peakprojections/peak-control-hat/README.md

# peak-control-hat
KiCad schematic and build files for the Peak Control Hat used with the Peak Controller Raspberry Pi
