peakprojections/peak-control-hat/Peak_Control_2CH_SSR_Interface_RevA/Peak_Control_2CH_SSR_Interface_RevA.kicad_pcb

## KiCad design Peak_Control_2CH_SSR_Interface_RevA/Peak_Control_2CH_SSR_Interface_RevA.kicad_pcb (2026-09-03)

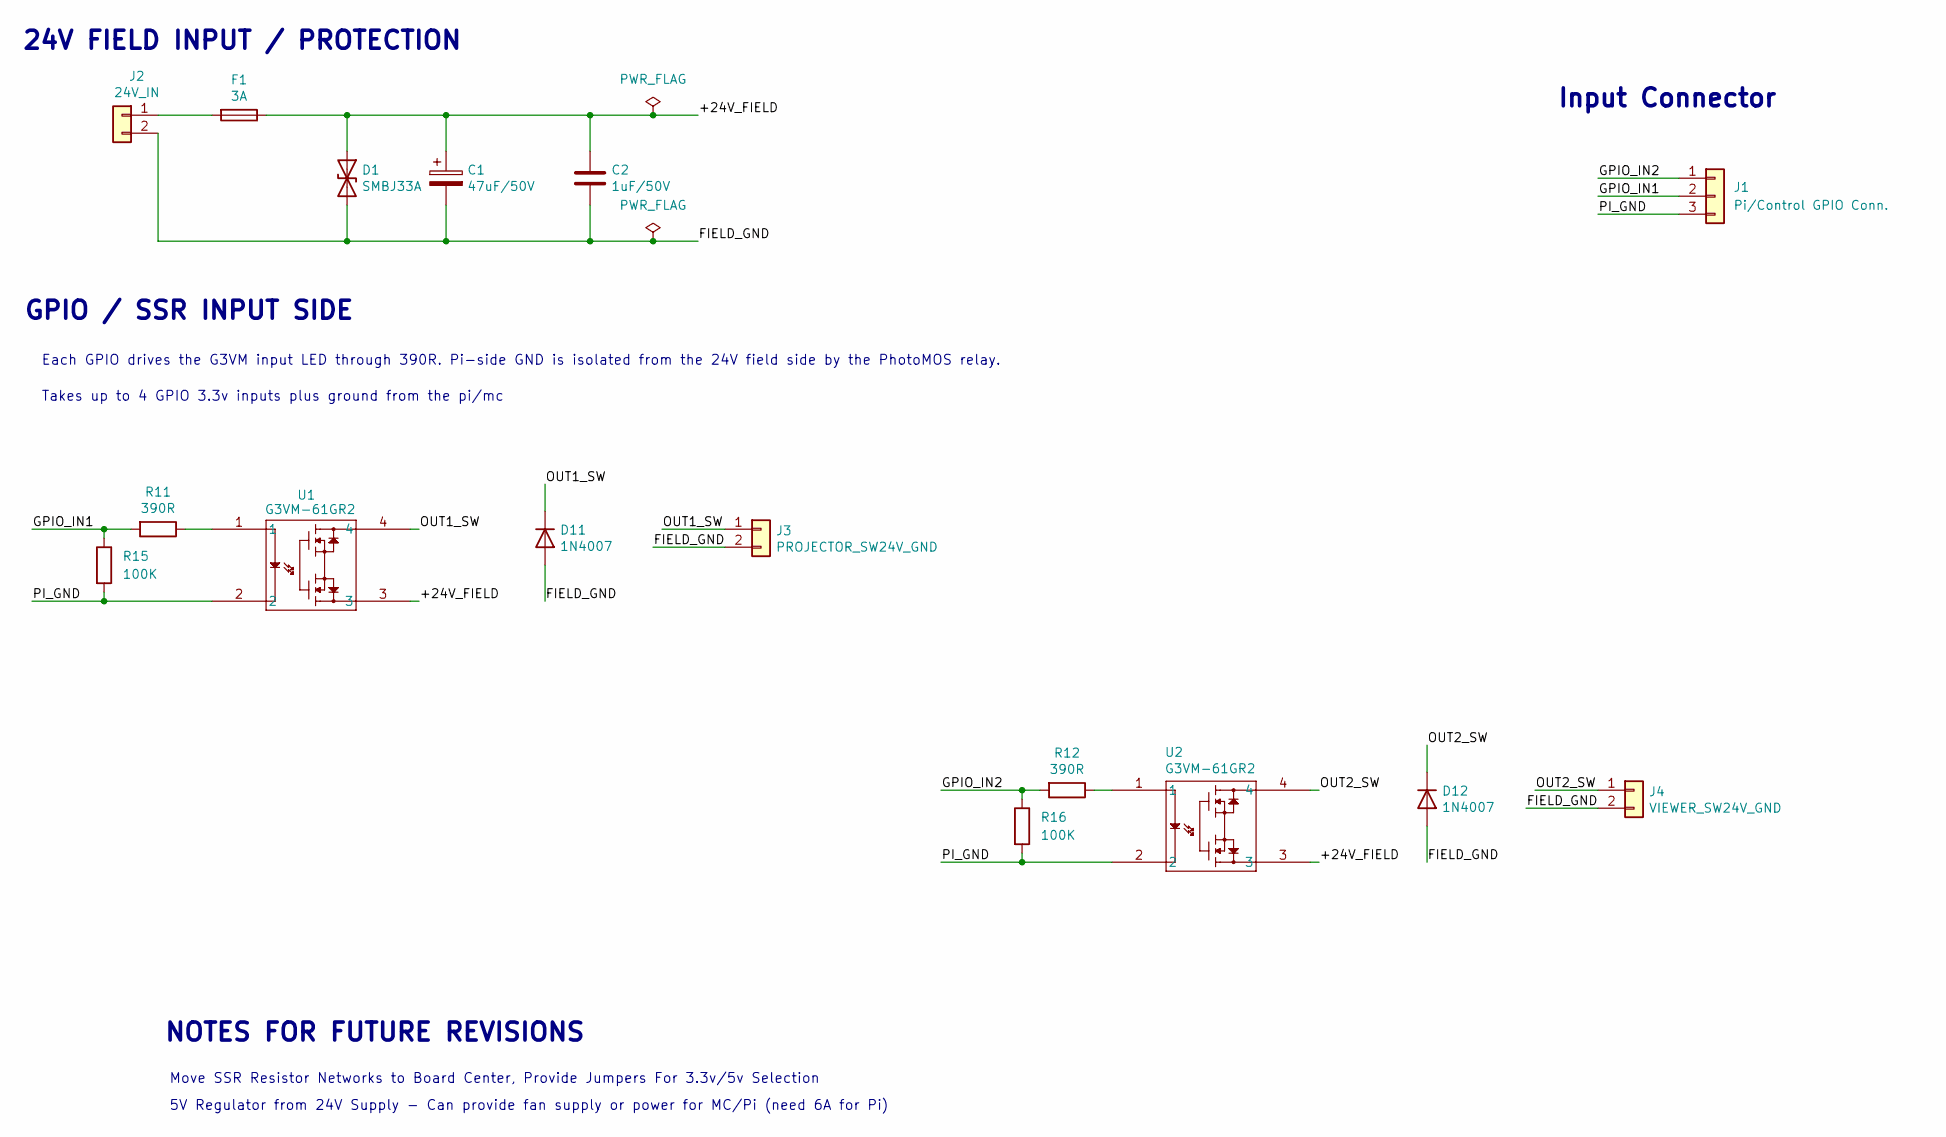
[picture p1: schematic Peak_Control_2CH_SSR_Interface_RevA.kicad_sch, Peak Control 2CH SSR Interface Rev A1.1]

Parts:
C1: 47uF/50V; CP_Radial_D8.0mm_P3.50mm; MPN 50RX3047MT78X11.5
C2: 1uF/50V; C_0805_2012Metric_Pad1.18x1.45mm_HandSolder; MPN 08055C105K4T2A
D1: SMBJ33A; D_SMB_Handsoldering; MPN SMBJ33A
D11, D12: 1N4007; D_DO-41_SOD81_P10.16mm_Horizontal; MPN 1N4007
F1: 3A; FUSE-TH_L22.6-W9.0; MPN 5x20 BLX-A XC-7
J1: Pi/Control GPIO Conn.; CONN-TH_3P-P5.08_DIBO_DB128V-5.08-3P-X; MPN DB128V-5.08-3P-GN-S
J2: 24V_IN; CONN-TH_YC0220500000G; MPN YC0220500000G
J3: PROJECTOR_SW24V_GND; CONN-TH_YC0220500000G; MPN YC0220500000G
J4: VIEWER_SW24V_GND; CONN-TH_YC0220500000G; MPN YC0220500000G
R11, R12: 390R; R_0805_2012Metric_Pad1.20x1.40mm_HandSolder; MPN RC0805FR-07390RL
R15, R16: 100K; R_0805_2012Metric_Pad1.20x1.40mm_HandSolder; MPN RC0805FR-07100KL
U1, U2: G3VM-61GR2; G-SOP4_OMR; MPN G3VM-61GR2(TR05)

Connections:
/+24V_FIELD: C1.1, C2.1, D1.1 (A1), F1.1, U1.3, U2.3
/FIELD_GND: C1.2, C2.2, D1.2 (A2), D11.2 (A), D12.2 (A), J2.2, J3.2, J4.2
/GPIO_IN1: J1.2, R11.2, R15.1
/GPIO_IN2: J1.1, R12.2, R16.1
/OUT1_SW: D11.1 (K), J3.1, U1.4
/OUT2_SW: D12.1 (K), J4.1, U2.4
/PI_GND: J1.3, R15.2, R16.2, U1.2, U2.2
unnamed: F1.2, J2.1
unnamed: R11.1, U1.1
unnamed: R12.1, U2.1

Notes on the sheet:
NOTES FOR FUTURE REVISIONS
Each GPIO drives the G3VM input LED through 390R. Pi-side GND is isolated from the 24V field side by the PhotoMOS relay.
5V Regulator from 24V Supply - Can provide fan supply or power for MC/Pi (need 6A for Pi)
Input Connector
24V FIELD INPUT / PROTECTION
GPIO / SSR INPUT SIDE
Move SSR Resistor Networks to Board Center, Provide Jumpers For 3.3v/5v Selection
Takes up to 4 GPIO 3.3v inputs plus ground from the pi/mc

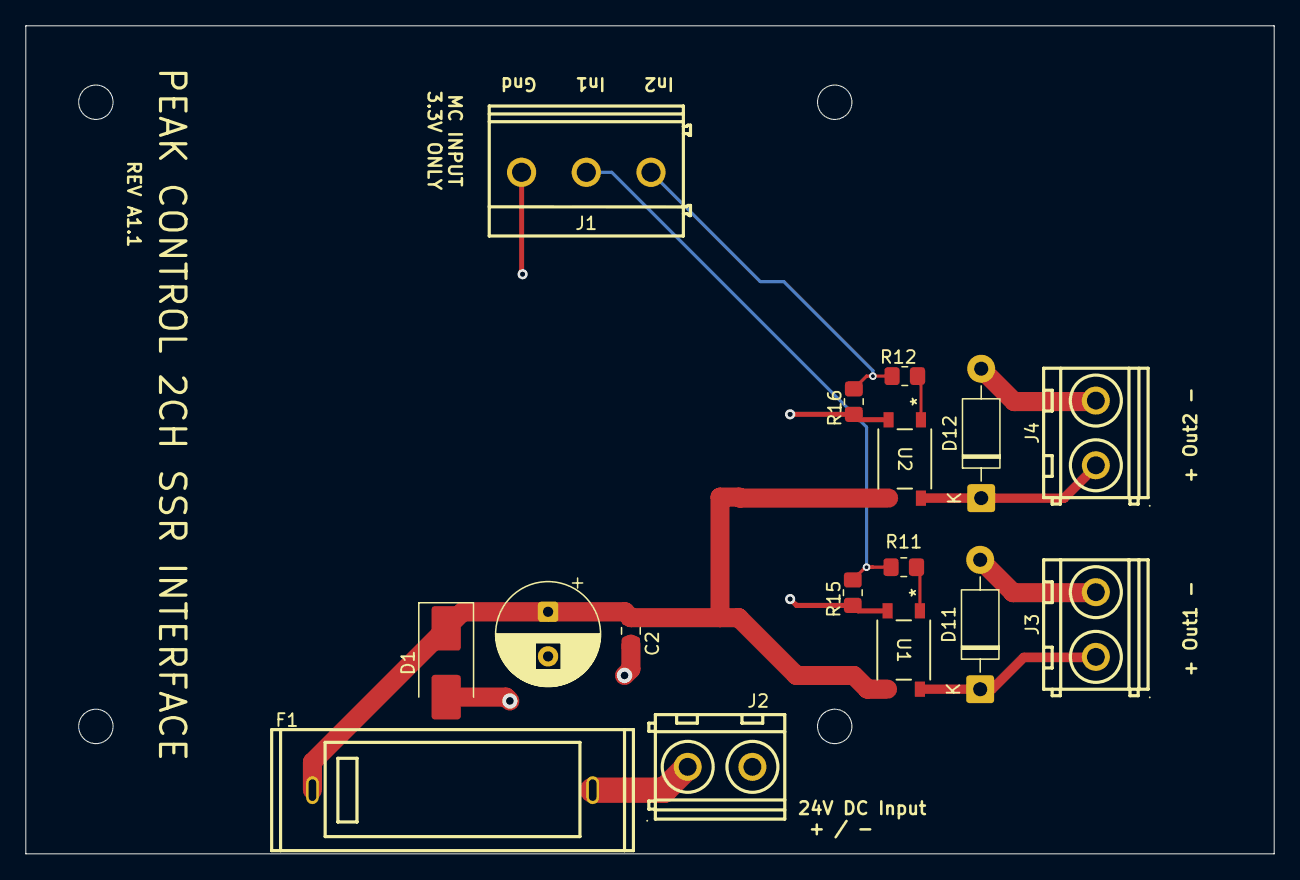
[picture p2: board Peak_Control_2CH_SSR_Interface_RevA.kicad_pcb from above]

Board: 4 copper layers, 98.0 x 65.0 mm, 16 parts (0 on the bottom side), 10 nets.
