peakprojections/peak-control-hat/Peak_Control_HAT_SSR_RevA/Peak_Control_HAT_SSR_RevA.kicad_pcb

## KiCad design Peak_Control_HAT_SSR_RevA/Peak_Control_HAT_SSR_RevA.kicad_pcb (2026-09-01)

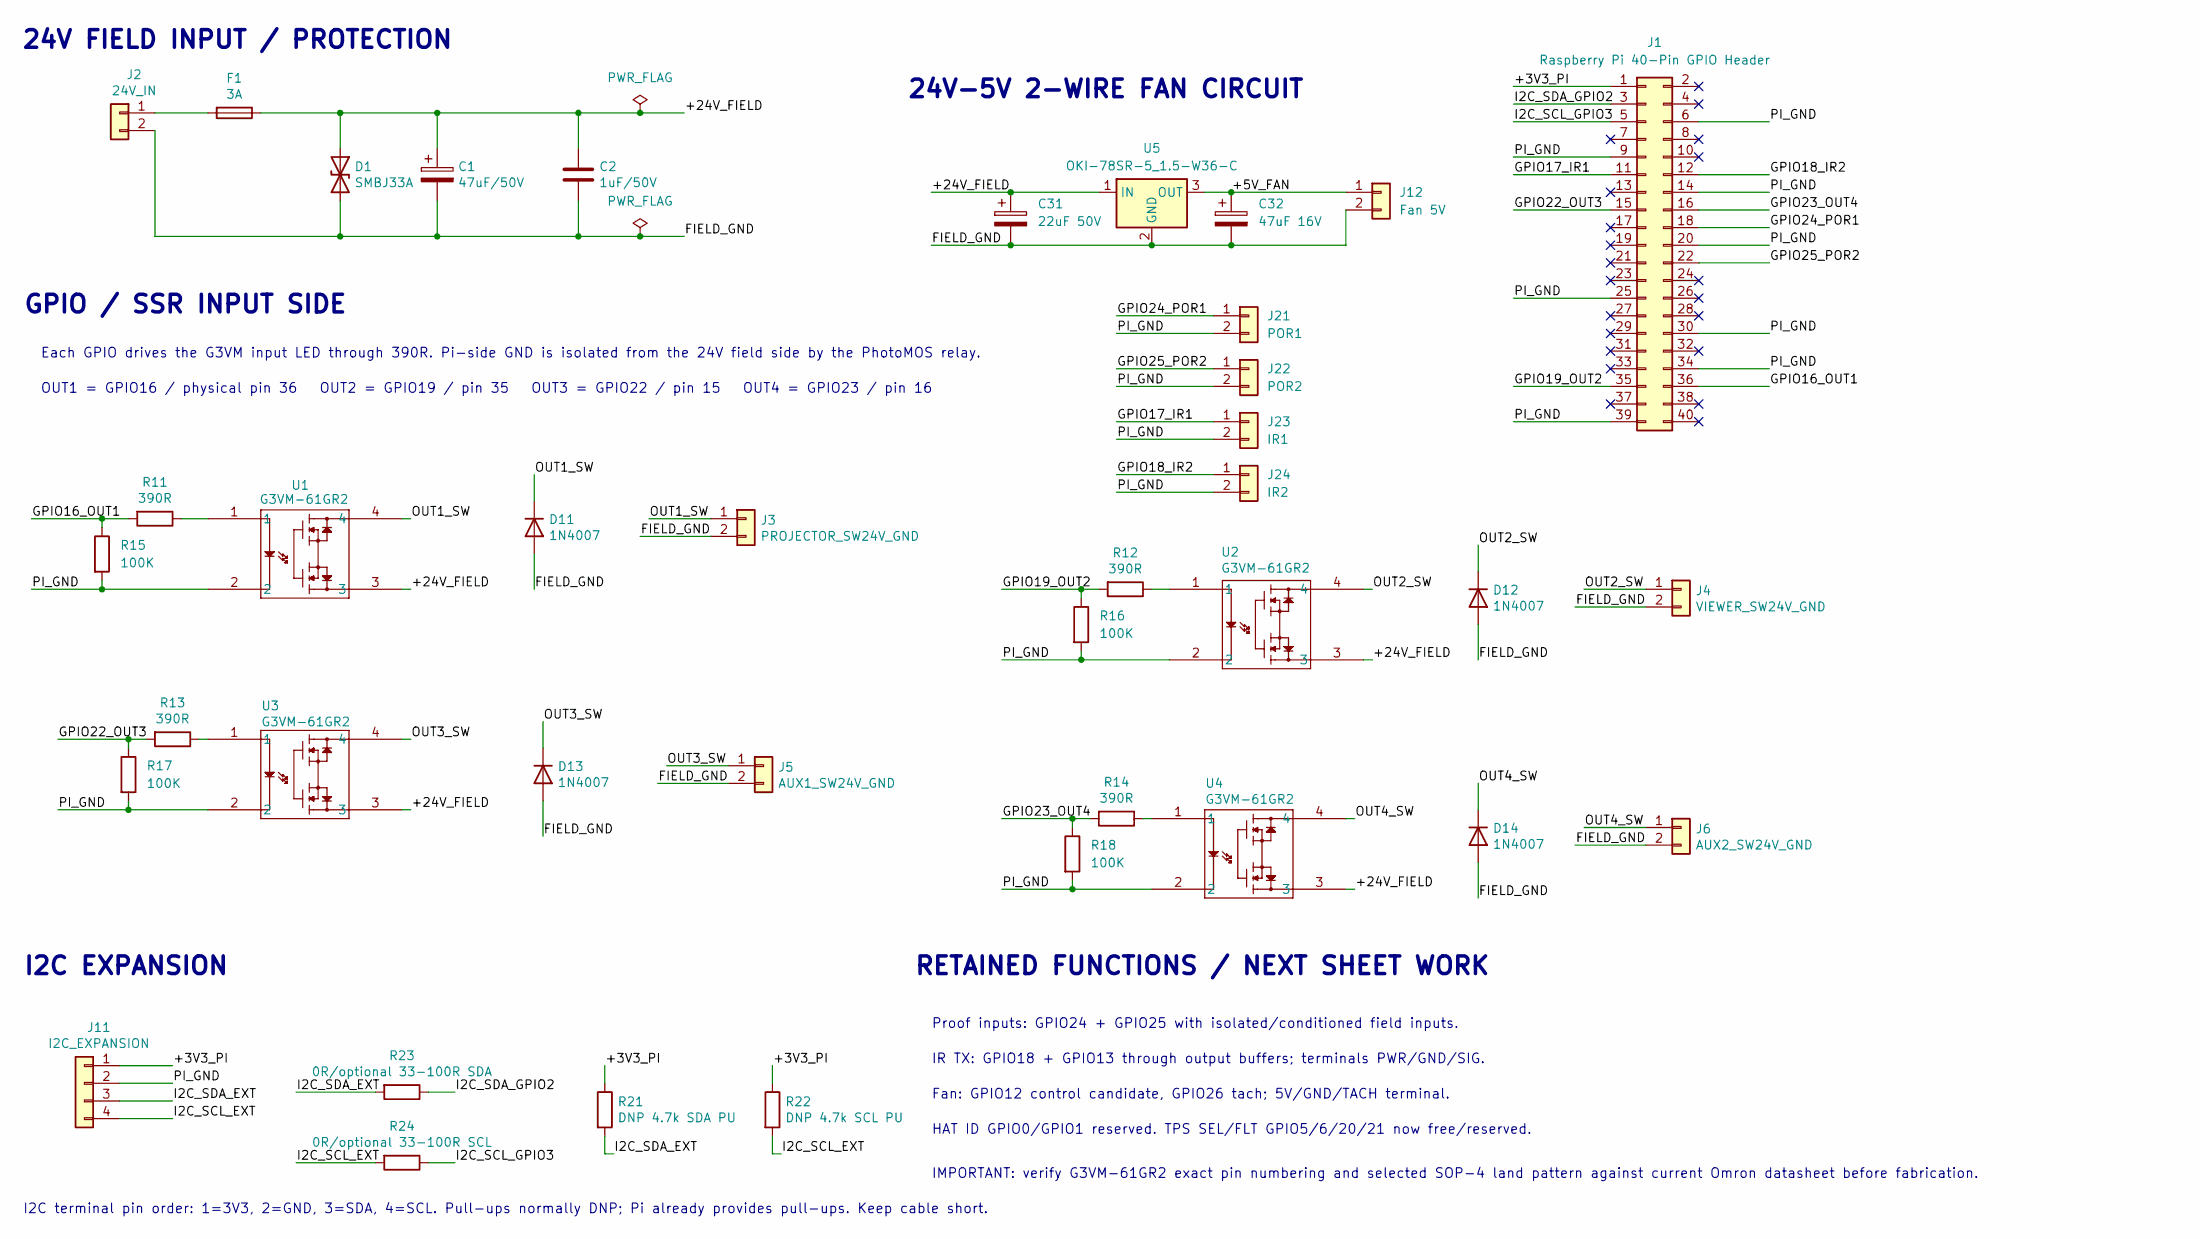
[picture p3: schematic Peak_Control_HAT_SSR_RevA.kicad_sch, Peak Control HAT SSR Rev A - Power Output Core]

Parts:
C1: 47uF/50V; CP_Radial_D8.0mm_P3.50mm
C2: 1uF/50V; C_0805_2012Metric_Pad1.18x1.45mm_HandSolder
C31: 22uF 50V; CP_Radial_D5.0mm_P2.00mm
C32: 47uF 16V; CP_Radial_D5.0mm_P2.00mm
D1: SMBJ33A; D_SMB_Handsoldering
D11, D12, D13, D14: 1N4007; D_DO-41_SOD81_P10.16mm_Horizontal
F1: 3A; Fuseholder_Clip-5x20mm_Bel_FC-203-22_Lateral_P17.80x5.00mm_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
J1: Raspberry Pi 40-Pin GPIO Header; PinSocket_2x20_P2.54mm_Vertical
J2: 24V_IN; TerminalBlock_Phoenix_MKDS-1,5-2-5.08_1x02_P5.08mm_Horizont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
J3: PROJECTOR_SW24V_GND; TerminalBlock_Phoenix_MKDS-1,5-2-5.08_1x02_P5.08mm_Horizont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
J4: VIEWER_SW24V_GND; TerminalBlock_Phoenix_MKDS-1,5-2-5.08_1x02_P5.08mm_Horizont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
J5: AUX1_SW24V_GND; TerminalBlock_Phoenix_MKDS-1,5-2-5.08_1x02_P5.08mm_Horizont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
J6: AUX2_SW24V_GND; TerminalBlock_Phoenix_MKDS-1,5-2-5.08_1x02_P5.08mm_Horizont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
J11: I2C_EXPANSION; TerminalBlock_Phoenix_MKDS-1,5-4-5.08_1x04_P5.08mm_Horizont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
J12: Fan 5V; JST_XH_B2B-XH-A_1x02_P2.50mm_Vertical
J21: POR1; TerminalBlock_Phoenix_MKDS-1,5-2-5.08_1x02_P5.08mm_Horizont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
J22: POR2; TerminalBlock_Phoenix_MKDS-1,5-2-5.08_1x02_P5.08mm_Horizont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
J23: IR1; TerminalBlock_Phoenix_MKDS-1,5-2-5.08_1x02_P5.08mm_Horizont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
J24: IR2; TerminalBlock_Phoenix_MKDS-1,5-2-5.08_1x02_P5.08mm_Horizont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
R11, R12, R13, R14: 390R; R_0805_2012Metric_Pad1.20x1.40mm_HandSolder
R15, R16, R17, R18: 100K; R_0805_2012Metric_Pad1.20x1.40mm_HandSolder
R21: DNP 4.7k SDA PU; R_0805_2012Metric_Pad1.20x1.40mm_HandSolder
R22: DNP 4.7k SCL PU; R_0805_2012Metric_Pad1.20x1.40mm_HandSolder
R23: 0R/optional 33-100R SDA; R_0805_2012Metric_Pad1.20x1.40mm_HandSolder
R24: 0R/optional 33-100R SCL; R_0805_2012Metric_Pad1.20x1.40mm_HandSolder
U1, U2, U3, U4: G3VM-61GR2; G-SOP4_OMR
U5: OKI-78SR-5_1.5-W36-C; Converter_DCDC_Murata_OKI-78SR_Vertical

Connections:
/+3V3_PI: J1.1, J11.1, R21.1, R22.1
/+5V_FAN: C32.1, J12.1, U5.3 (OUT)
/+24V_FIELD: C1.1, C2.1, C31.1, D1.1 (A1), F1.1, U1.3, U2.3, U3.3, U4.3, U5.1 (IN)
/FIELD_GND: C1.2, C2.2, C31.2, C32.2, D1.2 (A2), D11.2 (A), D12.2 (A), D13.2 (A), D14.2 (A), J2.2, J3.2, J4.2, J5.2, J6.2, J12.2, U5.2 (GND)
/GPIO16_OUT1: J1.36, R11.2, R15.1
/GPIO17_IR1: J1.11, J23.1
/GPIO18_IR2: J1.12, J24.1
/GPIO19_OUT2: J1.35, R12.2, R16.1
/GPIO22_OUT3: J1.15, R13.2, R17.1
/GPIO23_OUT4: J1.16, R14.2, R18.1
/GPIO24_POR1: J1.18, J21.1
/GPIO25_POR2: J1.22, J22.1
/I2C_SCL_EXT: J11.4, R22.2, R24.2
/I2C_SCL_GPIO3: J1.5, R24.1
/I2C_SDA_EXT: J11.3, R21.2, R23.2
/I2C_SDA_GPIO2: J1.3, R23.1
/OUT1_SW: D11.1 (K), J3.1, U1.4
/OUT2_SW: D12.1 (K), J4.1, U2.4
/OUT3_SW: D13.1 (K), J5.1, U3.4
/OUT4_SW: D14.1 (K), J6.1, U4.4
/PI_GND: J1.6, J1.9, J1.14, J1.20, J1.25, J1.30, J1.34, J1.39, J11.2, J21.2, J22.2, J23.2, J24.2, R15.2, R16.2, R17.2, R18.2, U1.2, U2.2, U3.2, U4.2
unnamed: F1.2, J2.1
unnamed: R11.1, U1.1
unnamed: R12.1, U2.1
unnamed: R13.1, U3.1
unnamed: R14.1, U4.1

Notes on the sheet:
I2C EXPANSION
HAT ID GPIO0/GPIO1 reserved. TPS SEL/FLT GPIO5/6/20/21 now free/reserved.
RETAINED FUNCTIONS / NEXT SHEET WORK
Each GPIO drives the G3VM input LED through 390R. Pi-side GND is isolated from the 24V field side by the PhotoMOS relay.
24V-5V 2-WIRE FAN CIRCUIT
IMPORTANT: verify G3VM-61GR2 exact pin numbering and selected SOP-4 land pattern against current Omron datasheet before fabrication.
24V FIELD INPUT / PROTECTION
GPIO / SSR INPUT SIDE
I2C terminal pin order: 1=3V3, 2=GND, 3=SDA, 4=SCL. Pull-ups normally DNP; Pi already provides pull-ups. Keep cable short.
Proof inputs: GPIO24 + GPIO25 with isolated/conditioned field inputs.
Fan: GPIO12 control candidate, GPIO26 tach; 5V/GND/TACH terminal.
IR TX: GPIO18 + GPIO13 through output buffers; terminals PWR/GND/SIG.
OUT1 = GPIO16 / physical pin 36 OUT2 = GPIO19 / pin 35 OUT3 = GPIO22 / pin 15 OUT4 = GPIO23 / pin 16

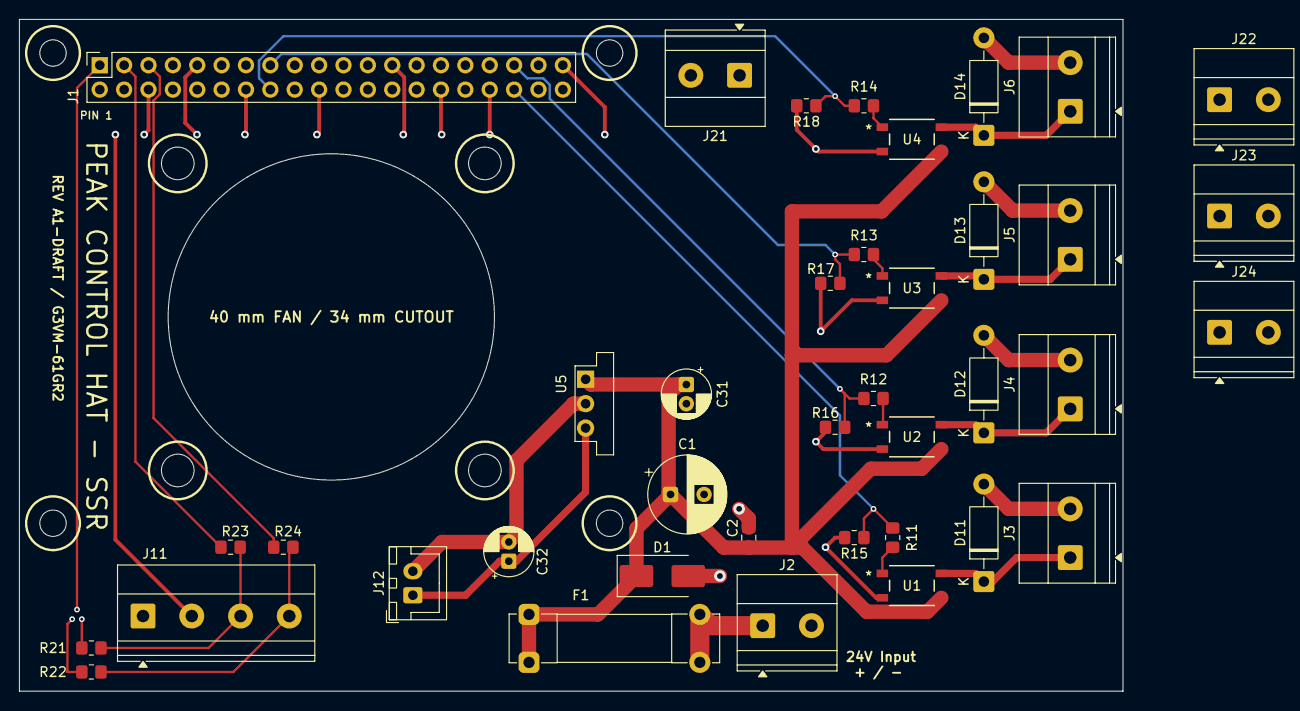
[picture p4: board Peak_Control_HAT_SSR_RevA.kicad_pcb from above]

Board: 4 copper layers, 115.0 x 70.0 mm, 39 parts (0 on the bottom side), 26 nets.
