peakprojections/peak-control-hat/(commit log)

2026-08-25 Initial project commit
    [Peak_Control_HAT_RevA.kicad_pcb, Pin_Map_RevA.csv]
2026-08-25 Add KiCad gitignore rules
2026-08-25 Remove KiCad lock file
2026-08-25 Add first Rev A output-core schematic draft
    [Peak_Control_HAT_RevA.sch]
2026-08-25 Align Rev A GPIO map with four-output and TPS diagnostics design
    [Pin_Map_RevA.csv]
2026-08-25 Add legacy schematic cache library for safe KiCad conversion
2026-08-25 Add project-local TPS272C45C KiCad symbol
2026-08-25 Make KiCad symbol libraries portable and add project symbol library
2026-08-25 Saved schematic with new format
    [Peak_Control_HAT_RevA.kicad_sch]
2026-08-25 Add canonical TPS272C45C schematic wiring plan
2026-08-25 Changed placeholder items with TPS272C45C
    [Peak_Control_HAT_RevA.kicad_sch]
2026-08-26 Added U1 connections with ERC report
    [Peak_Control_HAT_RevA.kicad_sch]
2026-08-26 Updated U1 connections and ERC report
    [Peak_Control_HAT_RevA.kicad_sch]
2026-08-27 Add SSR Rev A GPIO pin map
    [Pin_Map_SSR_RevA.csv]
2026-08-27 Add initial SSR Rev A power schematic
    [Peak_Control_HAT_SSR_RevA.sch]
2026-08-27 Add SSR Rev A KiCad PCB skeleton
    [Peak_Control_HAT_SSR_RevA.kicad_pcb]
2026-08-27 Add SSR Rev A KiCad project file
2026-08-28 Saving updated schematic before changing G3VM symbols
    [Peak_Control_HAT_SSR_RevA.kicad_pcb, Peak_Control_HAT_SSR_RevA.kicad_sch]
2026-08-30 Finalized Rev A component placement before routing
    [Peak_Control_HAT_SSR_RevA.kicad_pcb, Peak_Control_HAT_SSR_RevA.kicad_sch]
2026-08-31 Added most traces and zones
    [Peak_Control_HAT_SSR_RevA.kicad_pcb, Peak_Control_HAT_SSR_RevA.kicad_sch]
2026-08-31 Finished all traces, still needs full inspection
    [Peak_Control_HAT_SSR_RevA.kicad_pcb]
2026-08-31 Fixed a few traces and silkscreen placements, still requires full inspection
    [Peak_Control_HAT_SSR_RevA.kicad_pcb]
2026-09-01 Added pulldown resistors for SSRs
    [Peak_Control_HAT_SSR_RevA.kicad_pcb, Peak_Control_HAT_SSR_RevA.kicad_sch]
2026-09-01 Passed ERC checks, needs final pre-fab review
    [Peak_Control_HAT_SSR_RevA.kicad_sch]
2026-09-01 Created Peak_Control_SSR_Interface project for V1
    [Peak_Control_HAT_SSR_RevA.kicad_pcb, Peak_Control_HAT_SSR_RevA.kicad_sch, Peak_Control_SSR_Interface_RevA.kicad_pcb, Peak_Control_SSR_Interface_RevA.kicad_sch, Peak_Control_SSR_Interface_RevA.sch, Pin_Map_SSR_RevA.csv]
2026-09-01 Checkpoint for completed RevA, requires final verification
    [Peak_Control_SSR_Interface_RevA.kicad_pcb, Peak_Control_SSR_Interface_RevA.kicad_sch]
2026-09-02 Minor text updates before final pre-fab review
    [Peak_Control_SSR_Interface_RevA.kicad_pcb, Peak_Control_SSR_Interface_RevA.kicad_sch]
2026-09-02 Additional minor text updates before final pre-fab review
    [Peak_Control_SSR_Interface_RevA.kicad_sch]
2026-09-02 Replaced fuseholder F1 footprint
    [Peak_Control_SSR_Interface_RevA.csv, Peak_Control_SSR_Interface_RevA.kicad_pcb, Peak_Control_SSR_Interface_RevA.kicad_sch]
2026-09-02 Changed terminal block footprints to production items
    [Peak_Control_SSR_Interface_RevA.kicad_pcb, Peak_Control_SSR_Interface_RevA.kicad_sch]
2026-09-02 Added 2-CH Version
    [Peak_Control_2CH_SSR_Interface_RevA.csv, Peak_Control_2CH_SSR_Interface_RevA.kicad_pcb, Peak_Control_2CH_SSR_Interface_RevA.kicad_sch, Peak_Control_2CH_SSR_Interface_RevA.sch, Pin_Map_SSR_RevA.csv]
2026-09-03 Pre-fab checkpoint for 2ch version, file cleanup
    [Peak_Control_2CH_SSR_Interface_RevA.kicad_sch]
2026-09-03 Added updated BOM
    [Peak_Control_2CH_SSR_Interface_RevA.csv]
2026-09-03 Add JLCPCB assembly BOM for 2CH SSR interface
    [Peak_Control_2CH_SSR_Interface_RevA-JLC-BOM.csv]
2026-09-03 Post review, verified, pre-JLC_BOM and CPL
    [Peak_Control_2CH_SSR_Interface_RevA-B_Cu.gbr, Peak_Control_2CH_SSR_Interface_RevA-B_Mask.gbr, Peak_Control_2CH_SSR_Interface_RevA-B_Paste.gbr, Peak_Control_2CH_SSR_Interface_RevA-Edge_Cuts.gbr, Peak_Control_2CH_SSR_Interface_RevA-F_Cu.gbr, Peak_Control_2CH_SSR_Interface_RevA-F_Mask.gbr, Peak_Control_2CH_SSR_Interface_RevA-F_Paste.gbr, Peak_Control_2CH_SSR_Interface_RevA-In1_Cu.gbr]
2026-09-03 Add JLCPCB CPL for 2CH SSR interface
    [Peak_Control_2CH_SSR_Interface_RevA-JLC-CPL.csv]
